Lramir73/In-The-Bag_Sensor_Hub/Hub Diagrams/Block Diagram.png

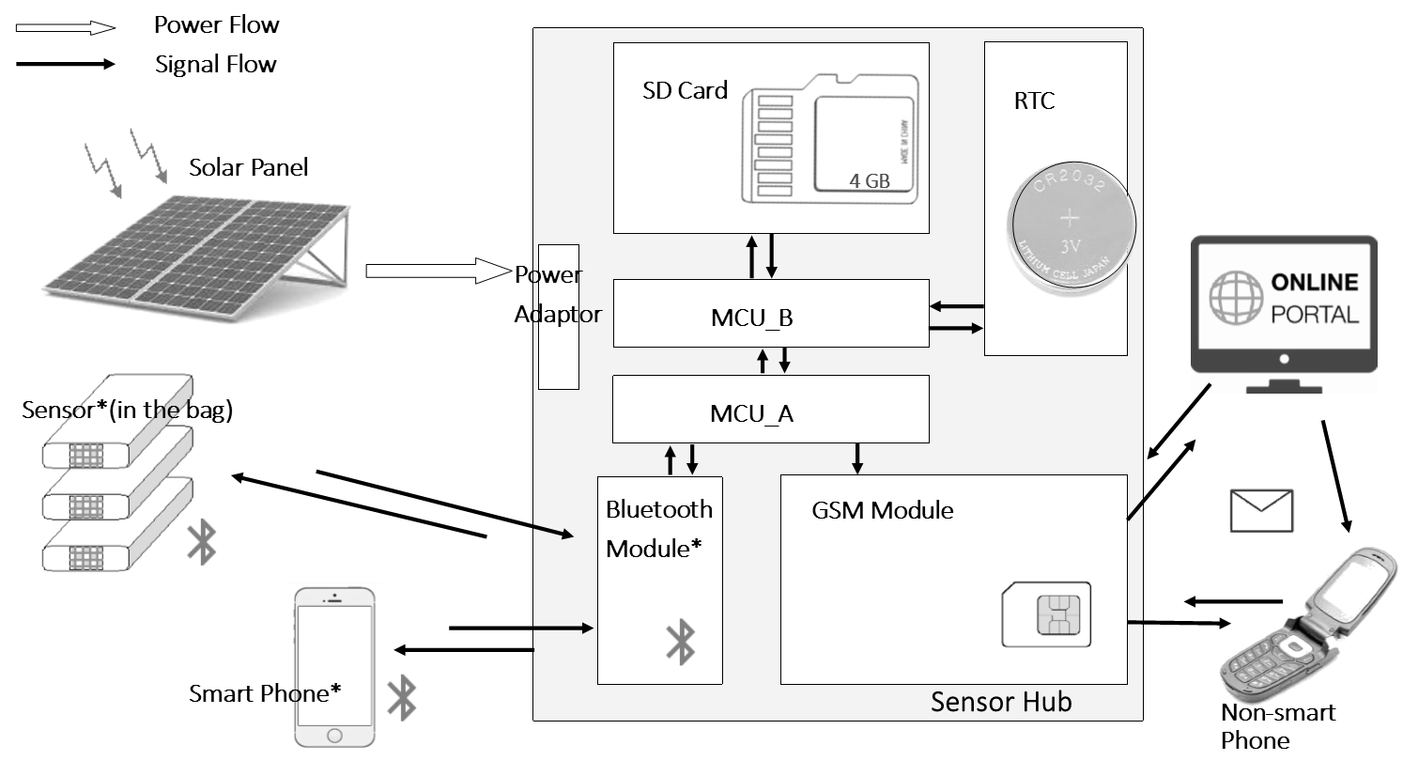
Hub Diagrams/Block Diagram.png
