Lramir73/In-The-Bag_Sensor_Hub/SD Card Files/CONFIG.TXT

hubID=1234
alertPhone=9546621746
portalPhone=9546621746
portalFreq=1
logFreq=1
critTemperature=30
critHumidity=20
