Lramir73/In-The-Bag_Sensor_Hub/Hub_A/Sensor_Support.ino

void checkSensor(byte num)
{
  // Get Sensor MAC Address from SensorList
  Serial.print(F("Checking Sensor "));
  Serial.println(num);
  Sensor * s = SensorList.get(num);

  // Connect to the Sensor
  Serial.println(F("Connecting to Sensor..."));  
  BTSerial.atCO('N',s->address);
  delay(1000);

  Serial.println(F("Requesting Data from Sensor..."));
  float t = 0;
  float h = 0;

  if(BTSerial.connected())
  {
    // Get Temperature from the sensor
    BTSerial.println("1");
    delay(1000);
    if(BTSerial.available())
    {
      t = BTSerial.parseFloat();
      Serial.print(F("Temperature: "));
      Serial.print(t);          // Prints Temperature as Float
      Serial.write(176);        // Prints Degree Symbol
      Serial.println(F("C"));   // Prints Celsius
    }

    // Wait before Sending Another Command
    delay(2000);
  
    // Get Humidity from the sensor
    BTSerial.println("2");
    delay(1000);
    if(BTSerial.available())
    {
      h = BTSerial.parseFloat();
      Serial.print(F("Humidity: "));
      Serial.print(h);
      Serial.println(F(" %RH"));
    }

    // Disconnnect from the sensor
    BTSerial.atTEST();
  }
  else
  {
    Serial.print(F("Could not connect to Sensor ")); 
    Serial.print(num);
    Serial.println(F("!"));  
  }
  
  
  // Send Data To Be Recorded In SD Card
  SerialB.listen();
  clearAllBuffers();
  sendData(num, t, h);

  // Check if critical Temperature or Humidity
  if(t >= critTemp && h >= critHum)
    sendAlert(1);
  else if(t >= critTemp)
    sendAlert(2);
  else if(h >= critHum)
    sendAlert(3);

  Serial.print(F("Done Checking Sensor "));
  Serial.println(num);
  
  // Return to listening to Bluetooth
  BTSerial.listen();
}


void checkAllSensors()
{
  // Set Busy Status
  digitalWrite(BUSY_LED, HIGH);
  
  Serial.println(F("Performing a Sensor Check!"));

  // Loop through and check each sensor 
  for(byte i = 0; i < SensorList.size(); i++)
    checkSensor(i);

  Serial.println(F("Done Checking All Sensors!"));
  
  // Notify Hub_B that the sensor check is done
  sendGetCommand(24);
  
  // Clear Busy Status
  digitalWrite(BUSY_LED, LOW);
}
