Lramir73/In-The-Bag_Sensor_Hub/Hub_A/Other.ino

void clearAllBuffers()
{
  memset(Buffer, 0, BUFF_SIZE);   // Clear contents of Buffer
  memset(Command, 0, CMD_SIZE);   // Clear contents of Buffer
  memset(Data, 0, DATA_SIZE);     // Clear contents of Buffer
}

void clearBuffer()
{
  memset(Buffer, 0, BUFF_SIZE);   // Clears main Buffer
}

void clearData()
{
  memset(Data, 0, DATA_SIZE);   // Clears main Buffer
}

void clearSettings()
{
  memset(HubID, '0', HUB_ID_SIZE);
  memset(AlertPhone, '0', PHONE_SIZE);
  memset(PortalPhone, '0', PHONE_SIZE);

  PortalFreq = 0;
  LoggingFreq = 0;

  critTemp = 100;
  critHum = 100;
}

bool checkAlarm()
{
  return digitalRead(FLAG);
}

bool checkModeChange()
{
  return digitalRead(MODE_SWITCH) != HubMode;
}

void switchMode()
{
  if(digitalRead(MODE_SWITCH) != HubMode)
  {
    // Set Busy LED
    digitalWrite(BUSY_LED, HIGH);
    
    HubMode = !HubMode; // Invert the HubMode
    BTSerial.atTEST();  // Make sure the module is disconnected
    
    // Switch to the correct role
    if(HubMode)
    {
      BTSerial.atROLE('1'); // Set to Master
      Serial.println(F("Entering Hub Mode"));
    }
    else
    {
      BTSerial.atROLE('0'); // Set to Slave
      Serial.println(F("Entering Config Mode"));
    }
    
    // Reset Bluetooth Module
    BTSerial.atRESET();

    // Set the Mode LED
    digitalWrite(MODE_LED, HubMode);

    // Clear Busy LED
    digitalWrite(BUSY_LED, LOW);
  }
}
