Lramir73/In-The-Bag_Sensor_Hub/(commit log)

2016-07-14 Create Regulator.txt
    Documentations for choosing 5v-3.3v regulator for HM-10
2016-07-18 Added Current Hub Revision
    This part of the Hub is for one of the Atmega chips.
2016-07-19 Added setup files for SD card
    [CONFIG.TXT]
2016-07-25 Updated Sensor Addresses
2016-08-10 Added multiple sensor support
    Still needs more testing
2016-08-31 Added old sensor code
2016-09-16 Fixed some commands between A and B
    [App_Commands.ino, Hub_A_Support.ino, Hub_B.ino, RTC.ino, SD.ino, Setup_Init.ino]
